kamilkarp/max2771eval/hardware/outputs/max2771eval.png

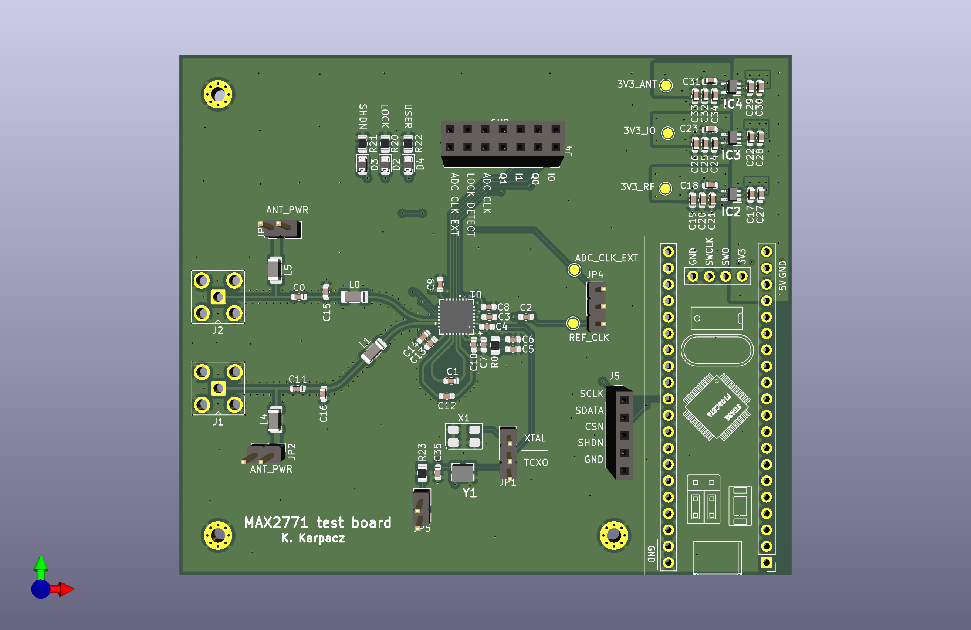
hardware/outputs/max2771eval.png
