kamilkarp/max2771eval/hardware/outputs/max2771eval.pdf

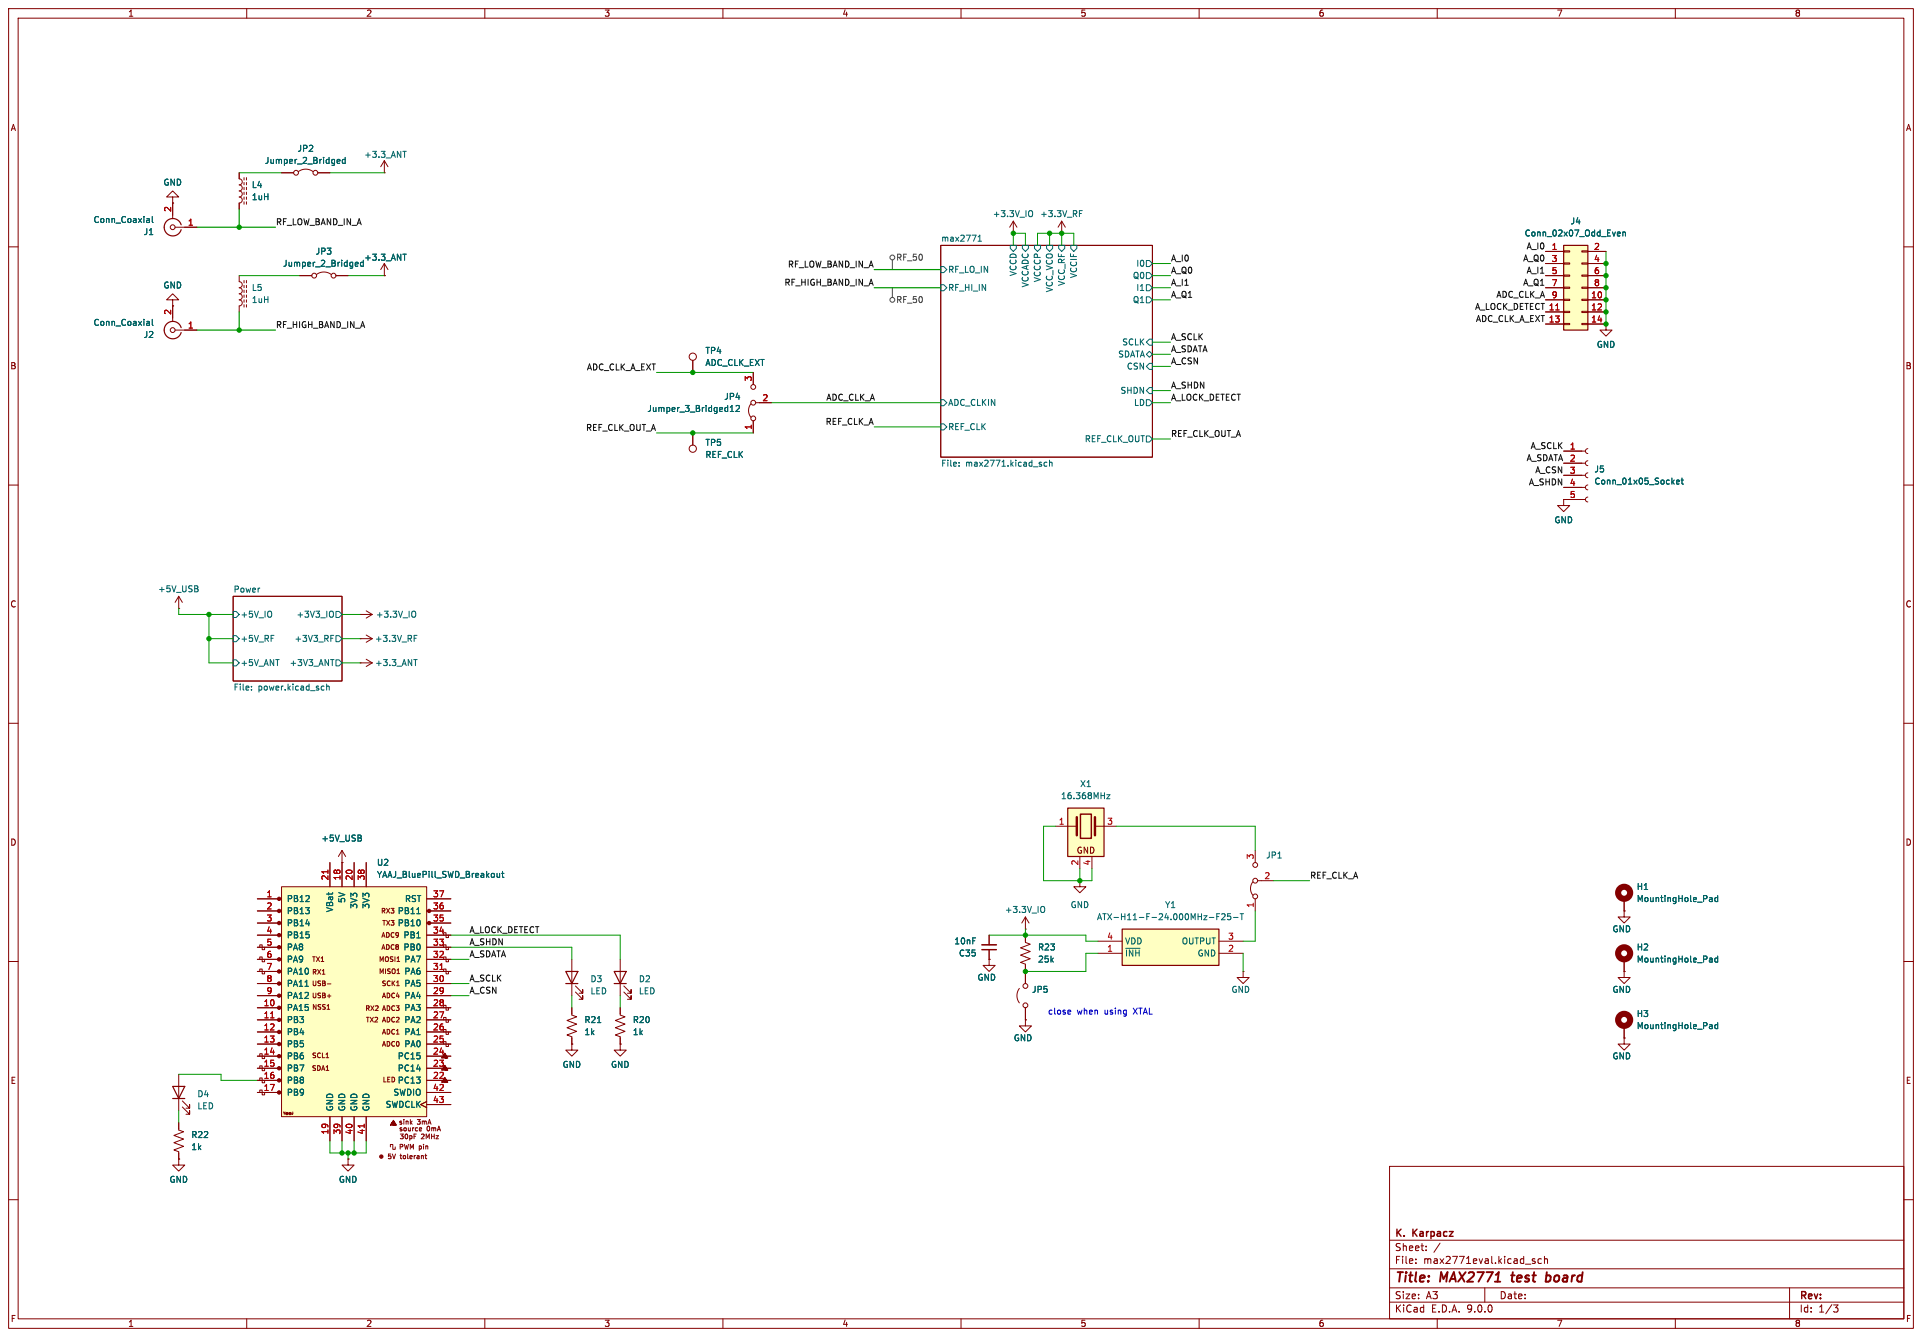
[picture p2: page 1]

close when using XTAL

Id: 1/3 Title: MAX2771 test board

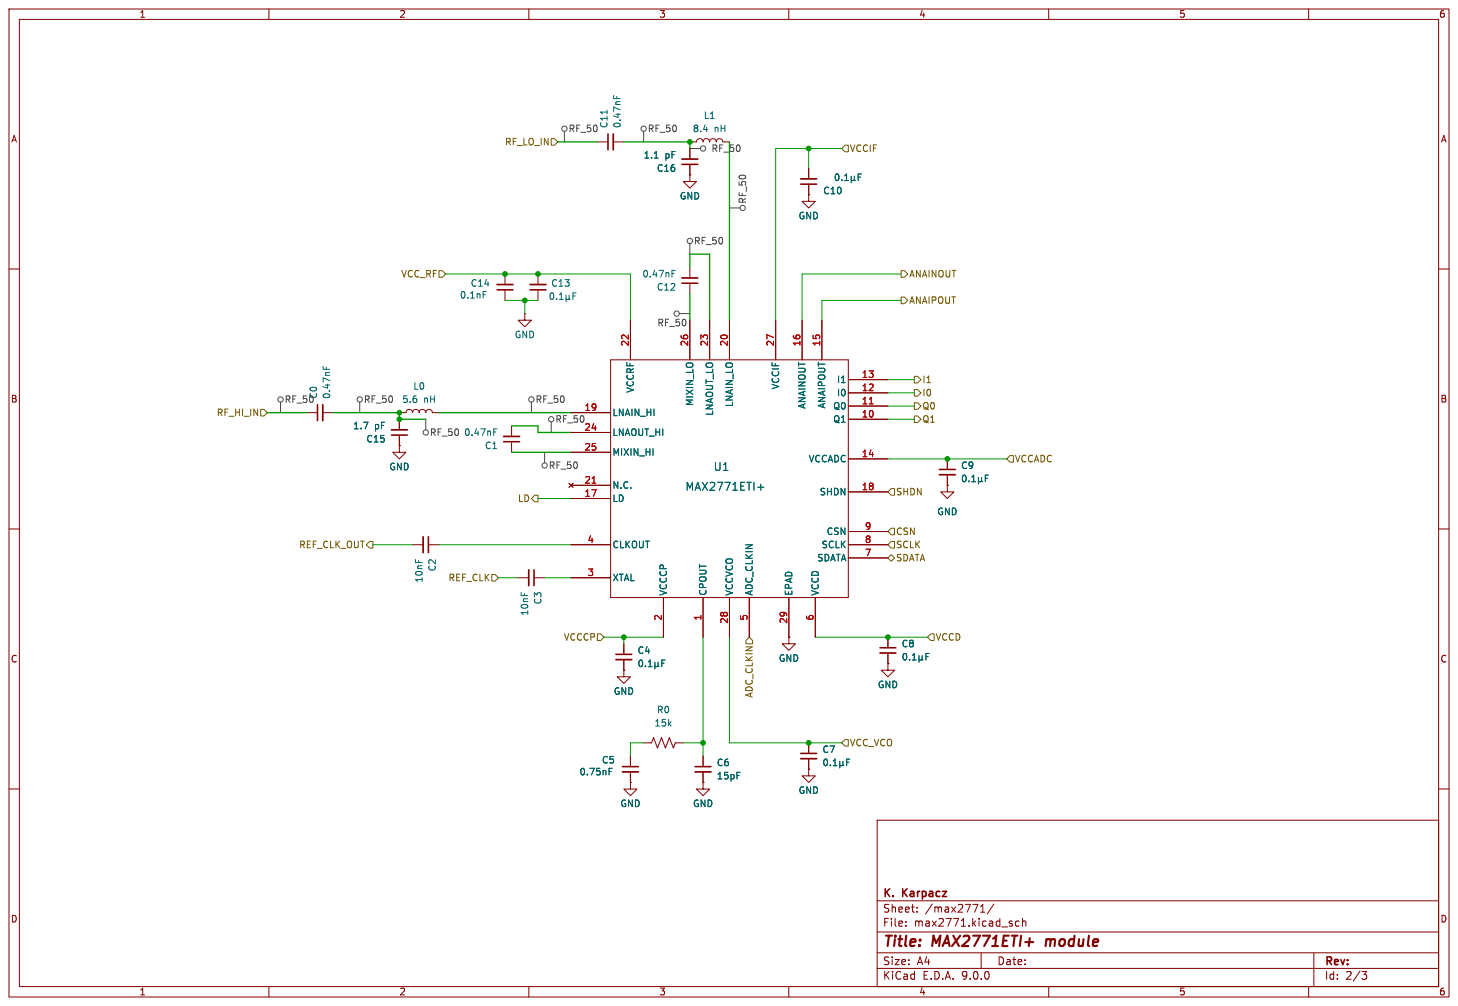
[picture p3: page 2]

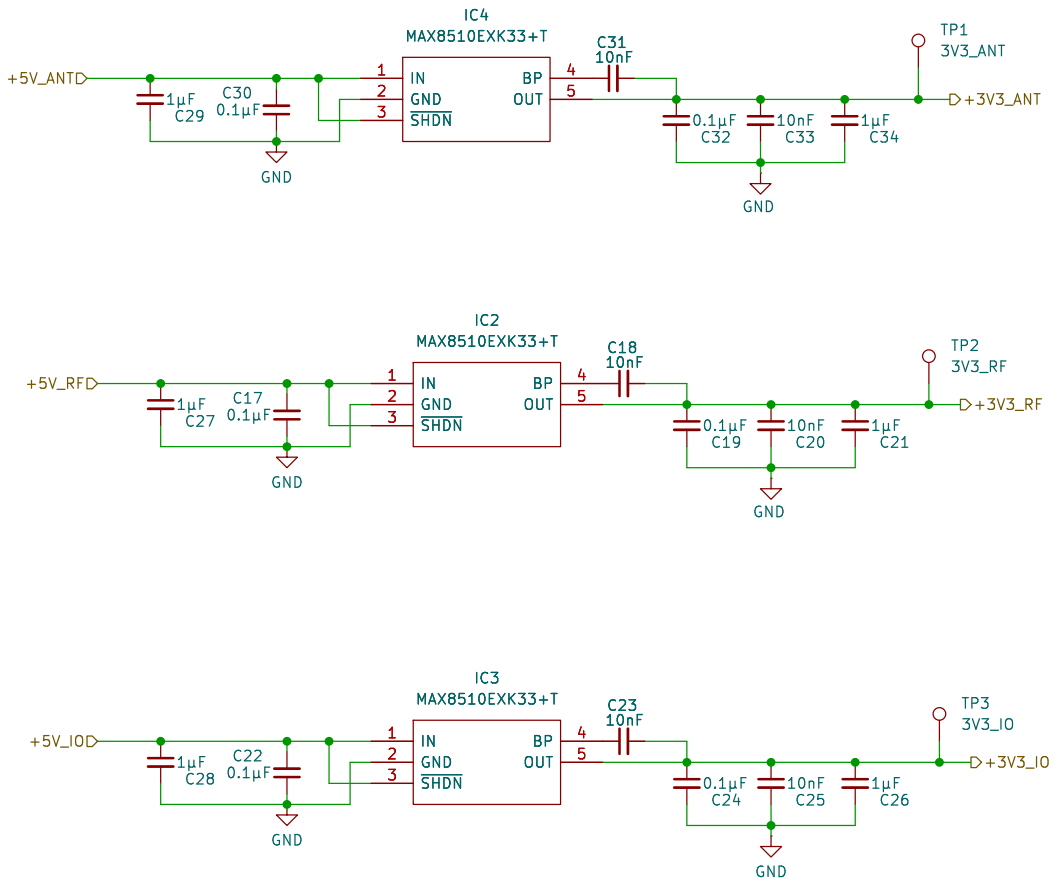
[picture p4: page 3]
