kamilkarp/max2771eval/hardware/outputs/max2771eval__Assembly.pdf

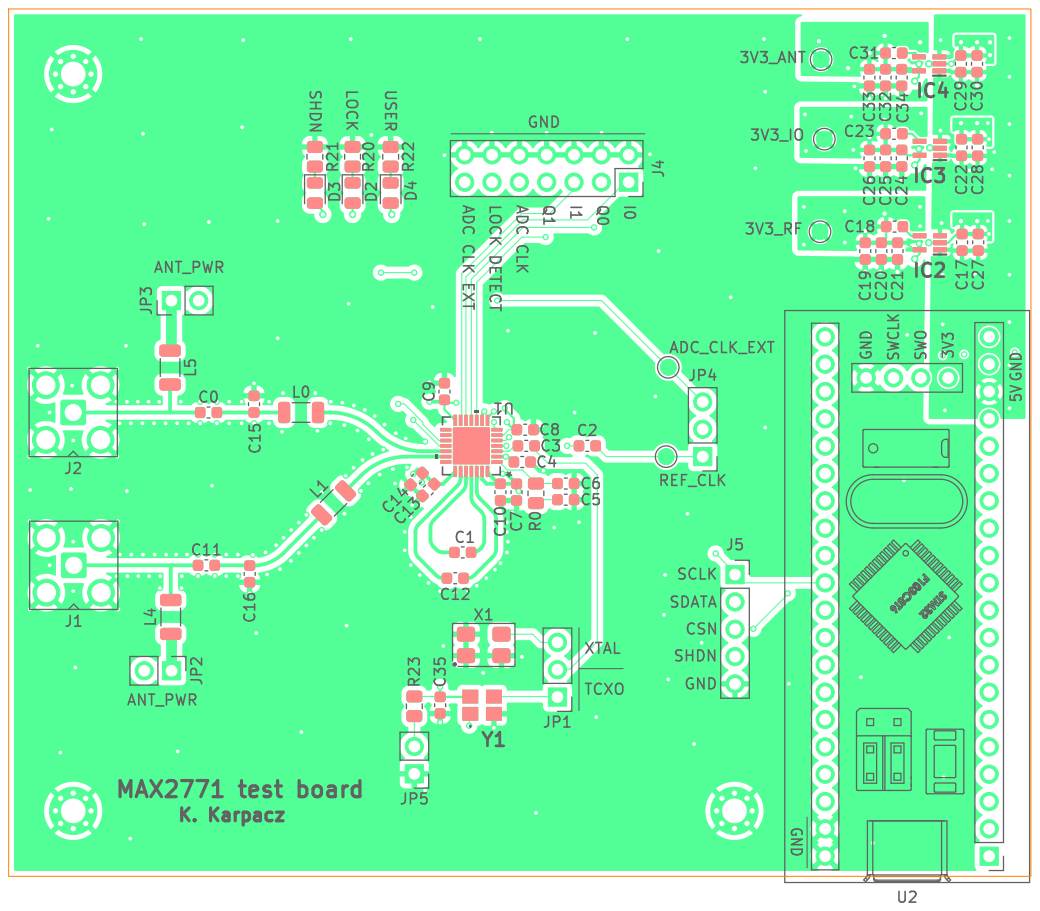
[picture p5: page 1]

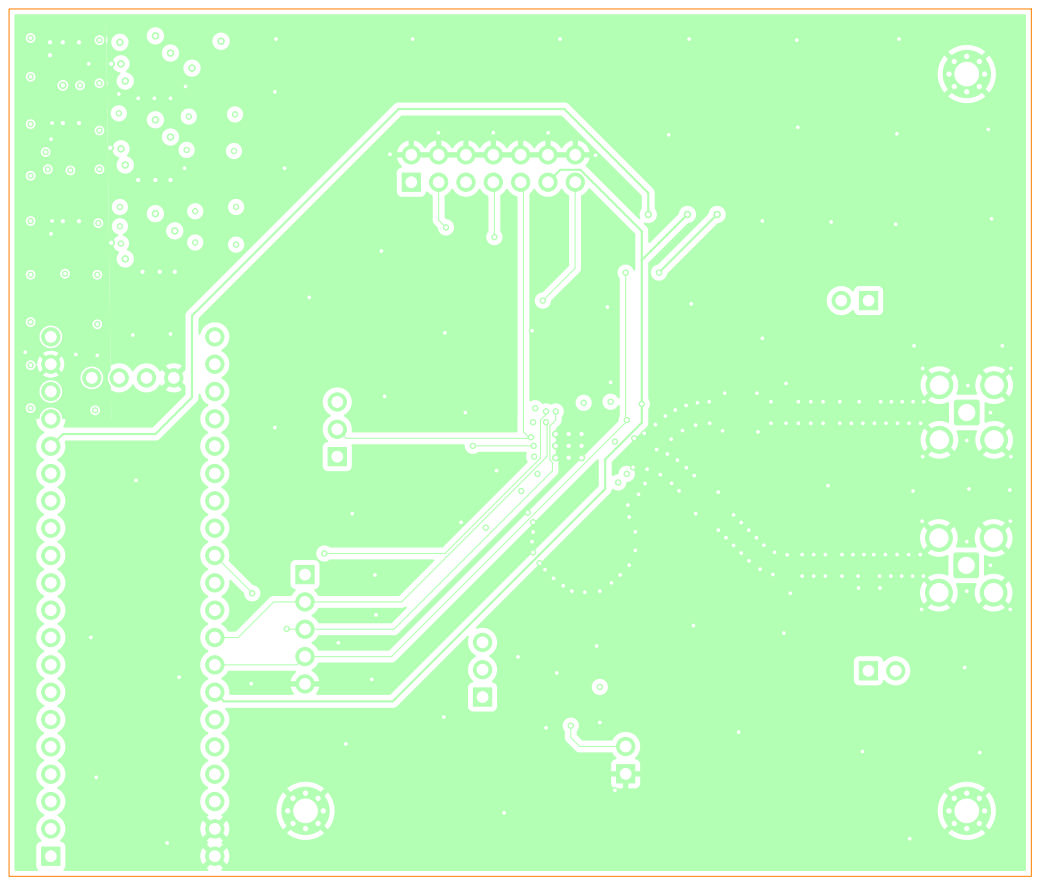
[picture p6: page 2]
D Date: KiCad; E.D.A. 9.0.0 Size: A4; Rev:; Id: /1 Title: File: max2771eval.kicad_pcb Sheet: Colored; BOT Board2Pdf:; Colored; BOT -; Page 2/2
