kamilkarp/max2771eval/hardware/max2771eval.kicad_pcb

## KiCad design hardware/max2771eval.kicad_pcb (2025-04-01)

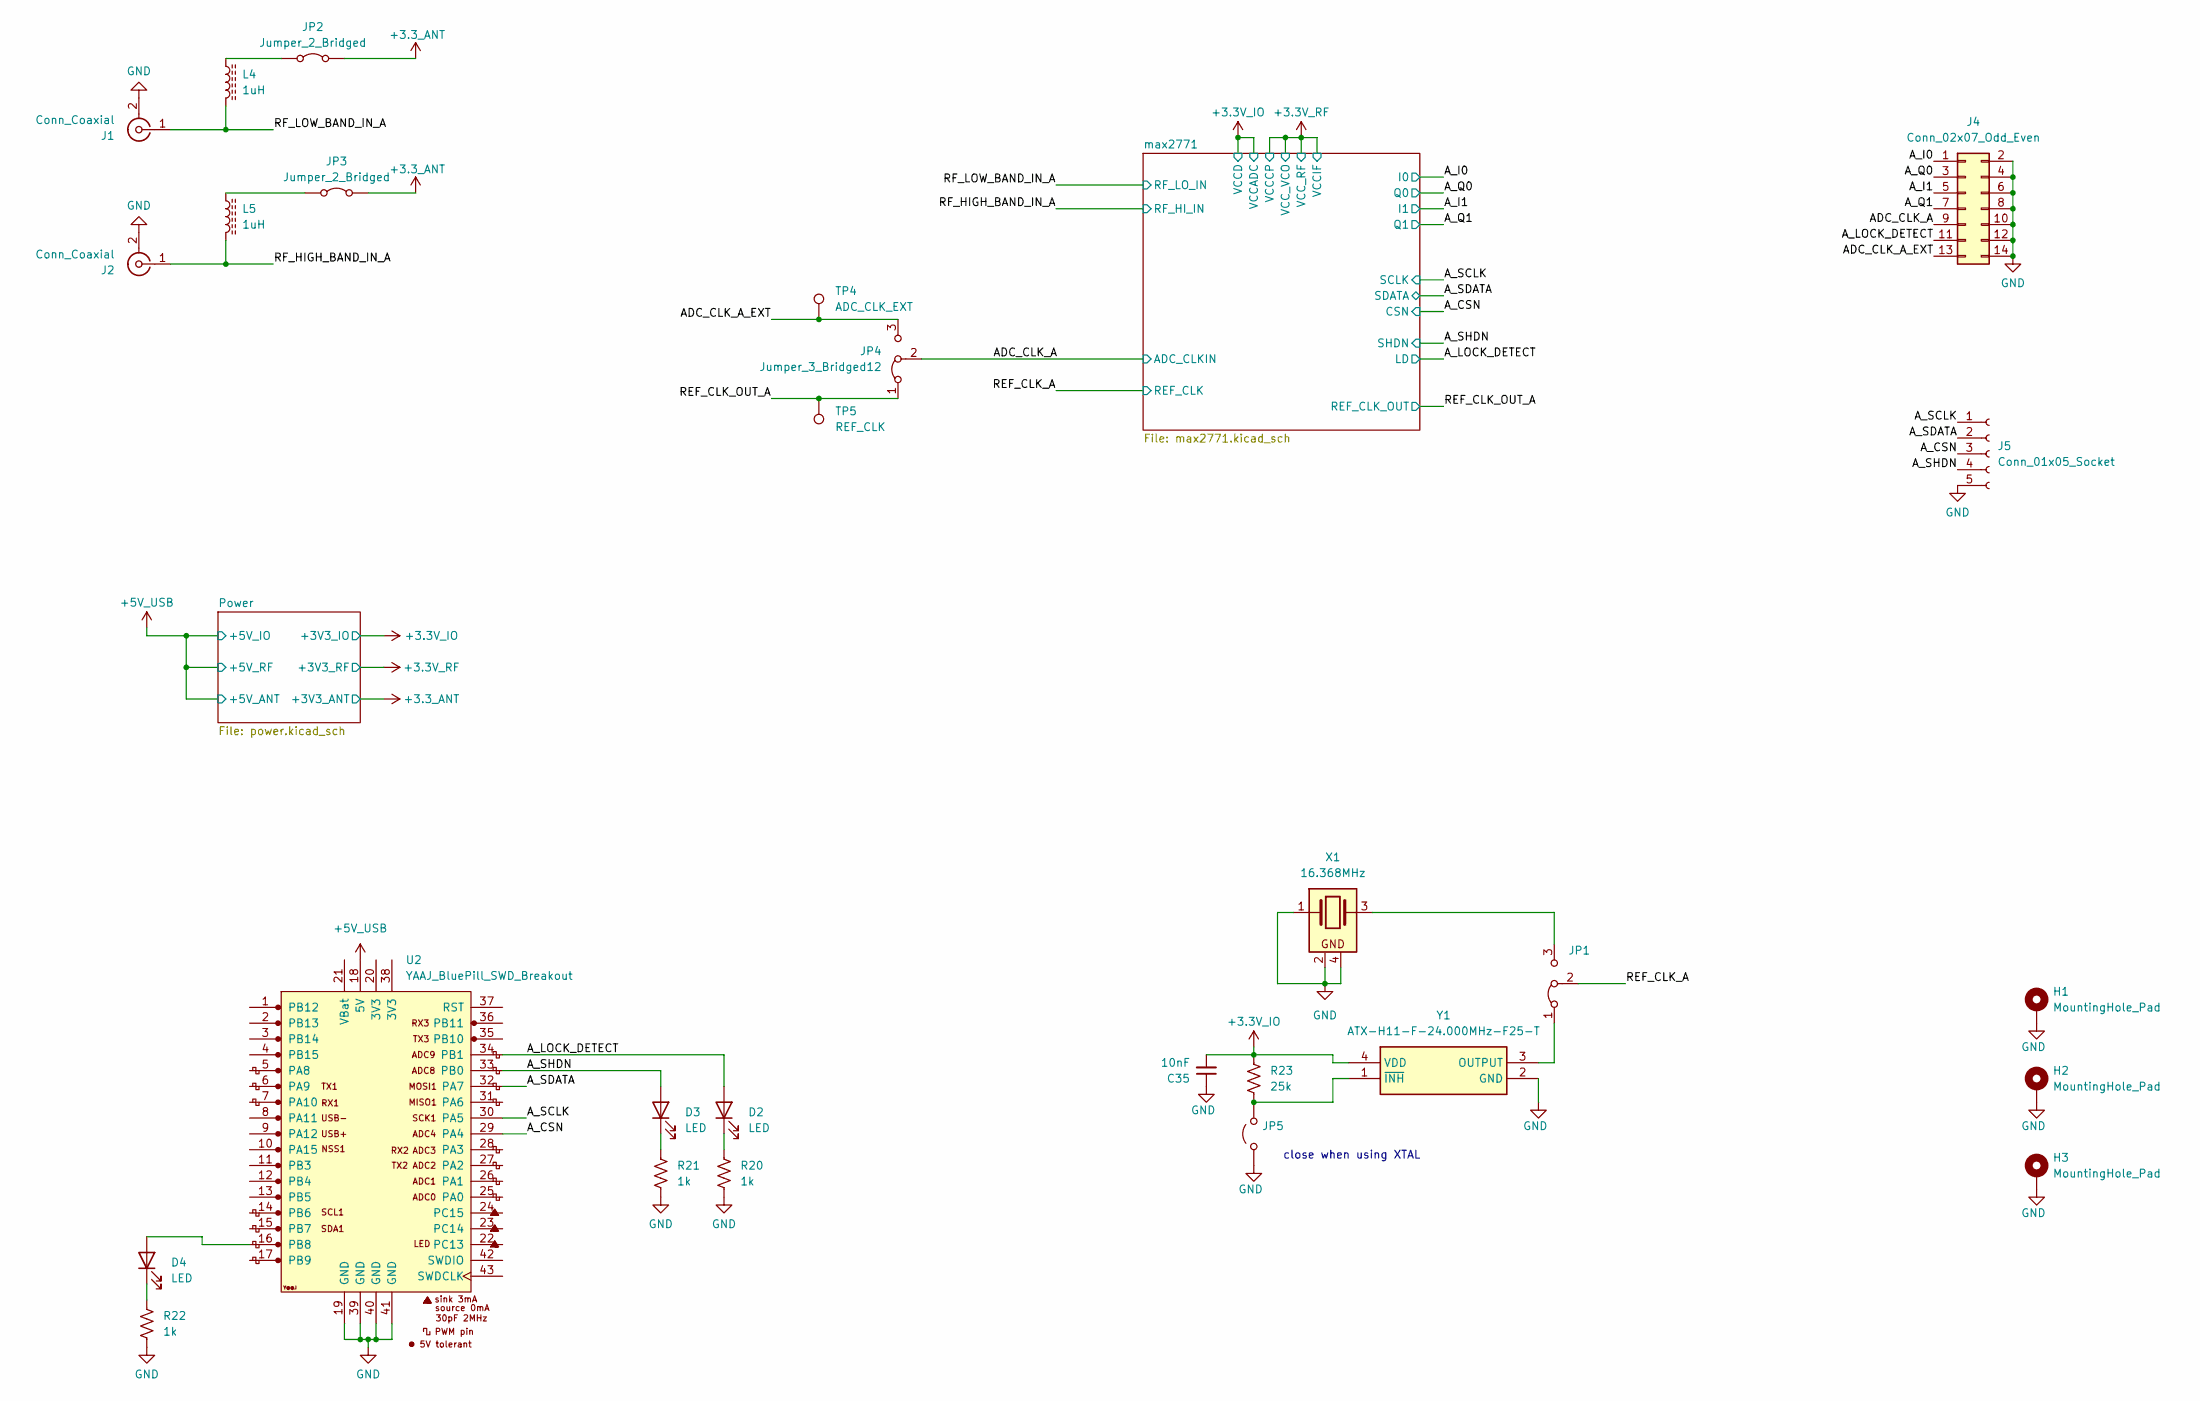
[picture p7: schematic max2771eval.kicad_sch, MAX2771 test board]

Parts:
C35: 10nF; C_0603_1608Metric
D2, D3, D4: LED; D_0805_2012Metric
H1, H2, H3: MountingHole_Pad; MountingHole_2.2mm_M2_Pad_Via
J1, J2: Conn_Coaxial; SMA_Amphenol_901-143_Horizontal
J4: Conn_02x07_Odd_Even; PinSocket_2x07_P2.54mm_Vertical
J5: Conn_01x05_Socket; PinSocket_1x05_P2.54mm_Vertical
JP1, JP4: Jumper_3_Bridged12; PinHeader_1x03_P2.54mm_Vertical
JP2, JP3: Jumper_2_Bridged; PinHeader_1x02_P2.54mm_Vertical
JP5: Jumper_2_Open; PinHeader_1x02_P2.54mm_Vertical
L4, L5: 1uH; L_1206_3216Metric
R20, R21, R22: 1k; R_0805_2012Metric
R23: 25k; R_0805_2012Metric
TP4: ADC_CLK_EXT; TestPoint_Pad_D1.5mm
TP5: REF_CLK; TestPoint_Pad_D1.5mm
U2: YAAJ_BluePill_SWD_Breakout; YAAJ_BluePill_SWD_1
X1: 16.368MHz; Crystal_SMD_5032-4Pin_5.0x3.2mm
Y1: ATX-H11-F-24.000MHz-F25-T; ATXH11F24000MHzF25T; Mouser Part Number 815-H11F24000MHZF25T

Connections:
+3.3V_IO: C35.2, R23.2, Y1.4 (VDD); also elsewhere on the board
+3.3_ANT: JP2.2 (B), JP3.2 (B); also elsewhere on the board
+5V_USB: U2.18 (5V); also elsewhere on the board
/ADC_CLK_A: J4.9, JP4.2 (C); also elsewhere on the board
/ADC_CLK_A_EXT: J4.13, JP4.3 (B), TP4.1
/A_CSN: J5.3, U2.29 (PA4); also elsewhere on the board
/A_I0: J4.1; also elsewhere on the board
/A_I1: J4.5; also elsewhere on the board
/A_LOCK_DETECT: D2.2 (A), J4.11, U2.34 (PB1); also elsewhere on the board
/A_Q0: J4.3; also elsewhere on the board
/A_Q1: J4.7; also elsewhere on the board
/A_SCLK: J5.1, U2.30 (PA5); also elsewhere on the board
/A_SDATA: J5.2, U2.32 (PA7); also elsewhere on the board
/A_SHDN: D3.2 (A), J5.4, U2.33 (PB0); also elsewhere on the board
/REF_CLK_A: JP1.2 (C); also elsewhere on the board
/REF_CLK_OUT_A: JP4.1 (A), TP5.1; also elsewhere on the board
/RF_HIGH_BAND_IN_A: J2.1 (In), L5.2; also elsewhere on the board
/RF_LOW_BAND_IN_A: J1.1 (In), L4.2; also elsewhere on the board
GND: C35.1, H1.1, H2.1, H3.1, J1.2 (Ext), J2.2 (Ext), J4.2, J4.4, J4.6, J4.8, J4.10, J4.12, J4.14, J5.5, JP5.1 (A), R20.1, R21.1, R22.1, U2.19 (GND), U2.39 (GND), U2.40 (GND), U2.41 (GND), X1.1, X1.2, X1.4, Y1.2 (GND); also elsewhere on the board
unnamed: D2.1 (K), R20.2
unnamed: D3.1 (K), R21.2
unnamed: D4.2 (A), U2.16 (PB8)
unnamed: D4.1 (K), R22.2
unnamed: JP1.1 (A), Y1.3 (OUTPUT)
unnamed: JP1.3 (B), X1.3
unnamed: JP2.1 (A), L4.1
unnamed: JP3.1 (A), L5.1
unnamed: JP5.2 (B), R23.1, Y1.1 (~INH)

Notes on the sheet:
close when using XTAL

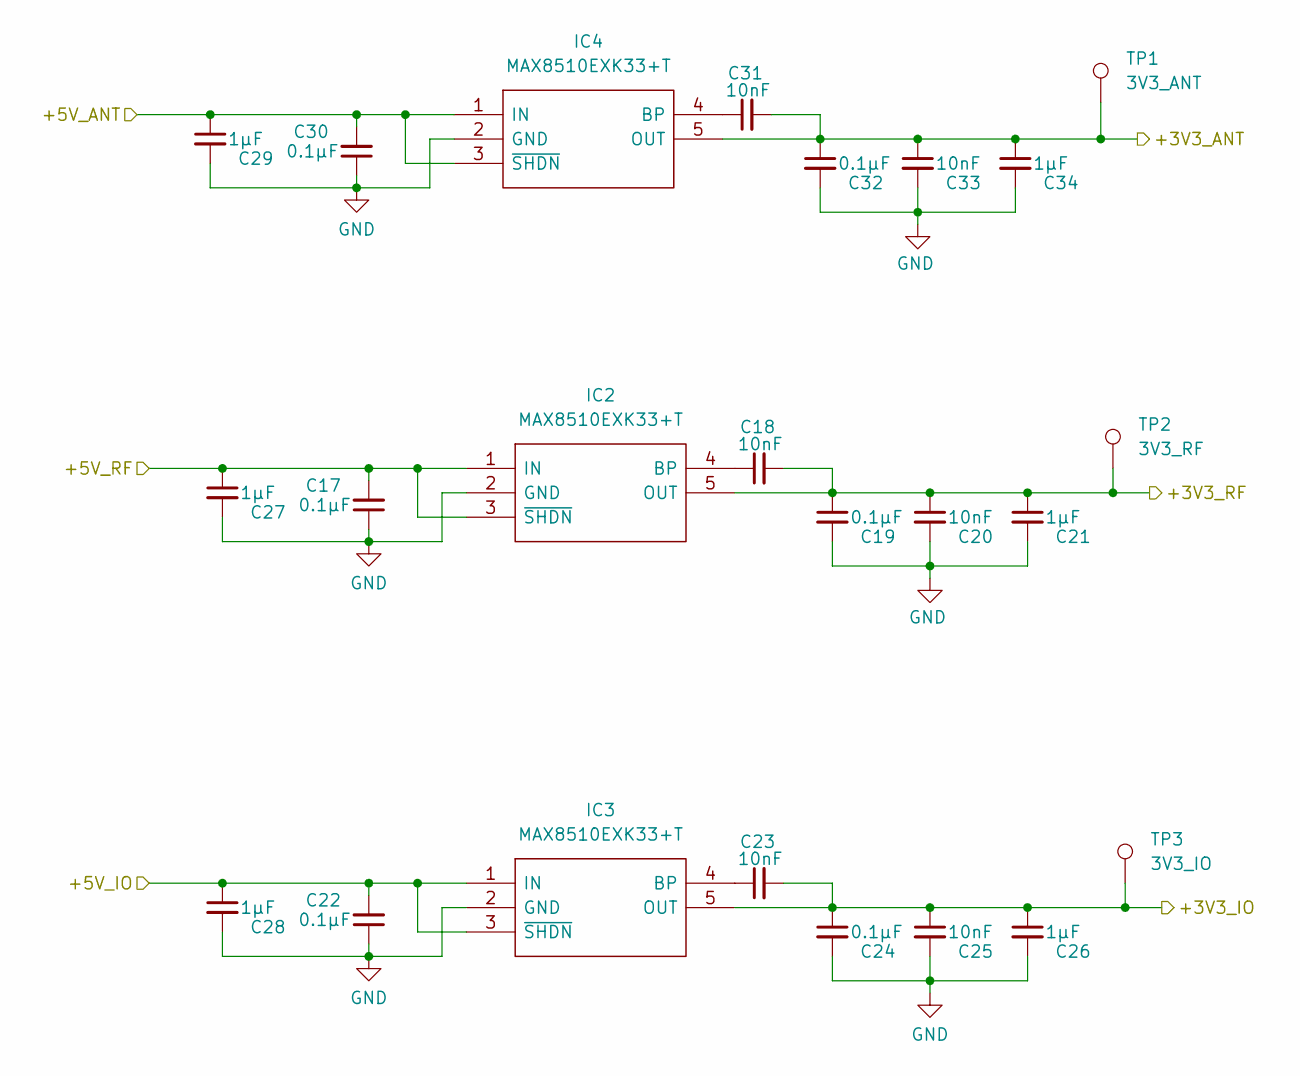
[picture p8: schematic power.kicad_sch]

Parts:
C17, C19, C22, C24, C30, C32: 0.1μF; C_0603_1608Metric
C18, C20, C23, C25, C31, C33: 10nF; C_0603_1608Metric
C21, C26, C27, C28, C29, C34: 1μF; C_0603_1608Metric
IC2, IC3, IC4: MAX8510EXK33+T; SOT65P210X110-5N; Mouser Part Number 700-MAX8510EXK33T
TP1: 3V3_ANT; TestPoint_Pad_D1.5mm
TP2: 3V3_RF; TestPoint_Pad_D1.5mm
TP3: 3V3_IO; TestPoint_Pad_D1.5mm

Connections:
+3.3V_IO: C23.2, C24.1, C25.1, C26.1, IC3.5 (OUT), TP3.1; also elsewhere on the board
+3.3V_RF: C18.2, C19.1, C20.1, C21.1, IC2.5 (OUT), TP2.1; also elsewhere on the board
+3.3_ANT: C31.2, C32.1, C33.1, C34.1, IC4.5 (OUT), TP1.1; also elsewhere on the board
+5V_USB: C17.2, C22.2, C27.1, C28.1, C29.1, C30.2, IC2.1 (IN), IC2.3 (~SHDN), IC3.1 (IN), IC3.3 (~SHDN), IC4.1 (IN), IC4.3 (~SHDN); also elsewhere on the board
GND: C17.1, C19.2, C20.2, C21.2, C22.1, C24.2, C25.2, C26.2, C27.2, C28.2, C29.2, C30.1, C32.2, C33.2, C34.2, IC2.2 (GND), IC3.2 (GND), IC4.2 (GND); also elsewhere on the board
unnamed: C18.1, IC2.4 (BP)
unnamed: C23.1, IC3.4 (BP)
unnamed: C31.1, IC4.4 (BP)

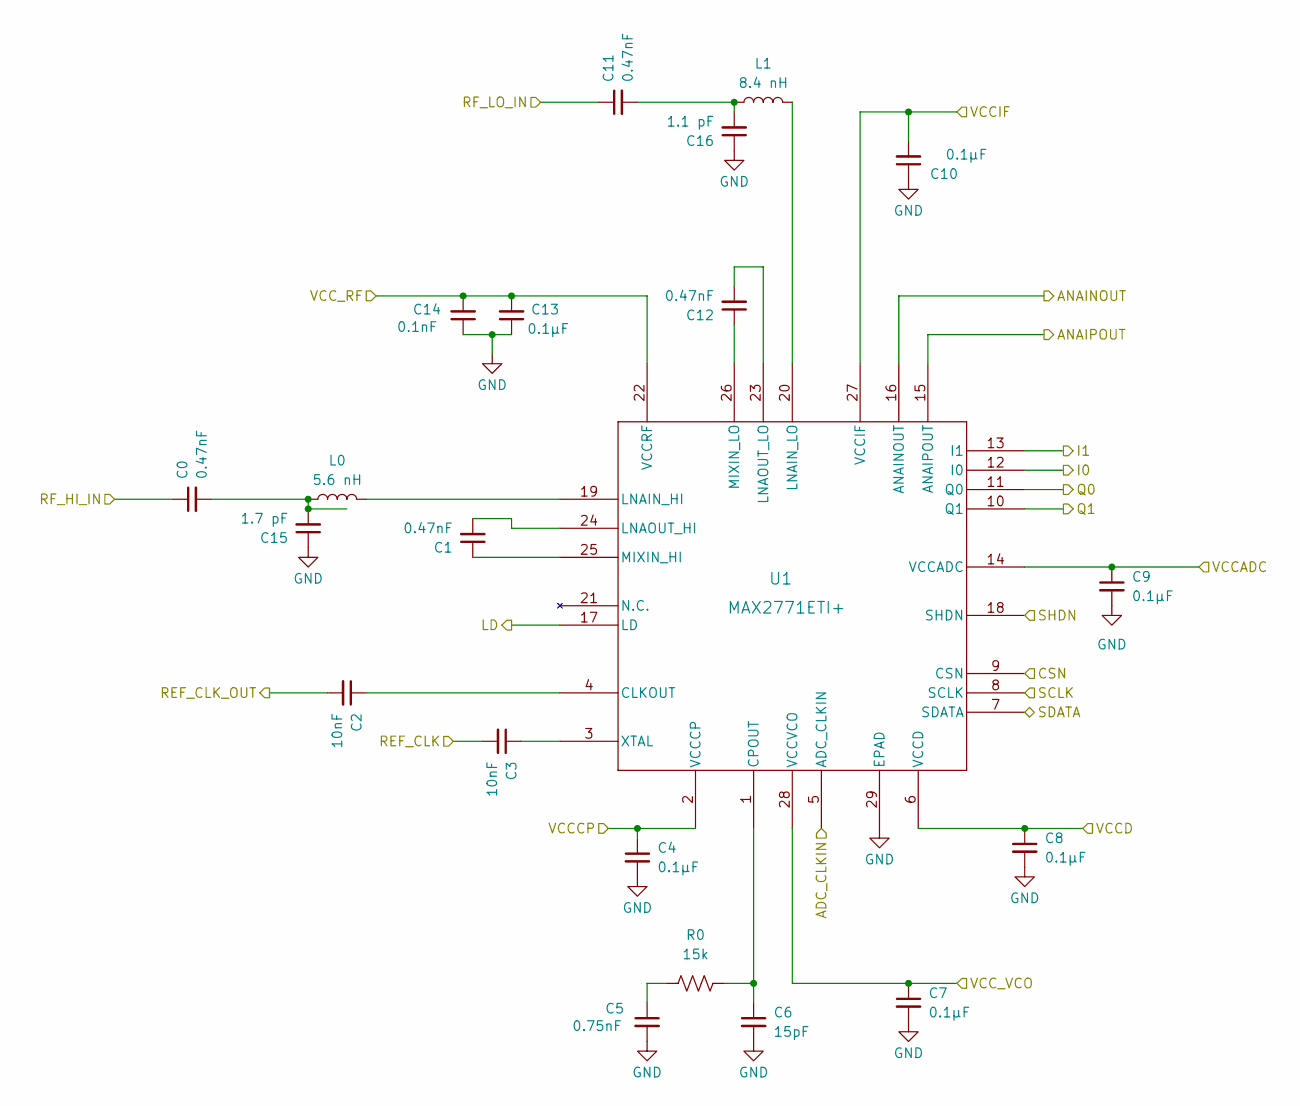
[picture p9: schematic max2771.kicad_sch, MAX2771ETI+ module]

Parts:
C0, C1, C11, C12: 0.47nF; C_0603_1608Metric
C2, C3: 10nF; C_0603_1608Metric
C4, C7, C8, C9, C10, C13: 0.1μF; C_0603_1608Metric
C5: 0.75nF; C_0603_1608Metric
C6: 15pF; C_0603_1608Metric
C14: 0.1nF; C_0603_1608Metric
C15: 1.7 pF; C_0603_1608Metric
C16: 1.1 pF; C_0603_1608Metric
L0: 5.6 nH; L_1206_3216Metric
L1: 8.4 nH; L_1206_3216Metric
R0: 15k; R_0805_2012Metric
U1: MAX2771ETI+; 21-0140L_T2855-8_MXM

Connections:
+3.3V_IO: C8.1, C9.1, U1.6 (VCCD), U1.14 (VCCADC); also elsewhere on the board
+3.3V_RF: C4.1, C7.1, C10.2, C13.2, C14.2, U1.2 (VCCCP), U1.22 (VCCRF), U1.27 (VCCIF), U1.28 (VCCVCO); also elsewhere on the board
/ADC_CLK_A: U1.5 (ADC_CLKIN); also elsewhere on the board
/A_CSN: U1.9 (CSN); also elsewhere on the board
/A_I0: U1.12 (I0); also elsewhere on the board
/A_I1: U1.13 (I1); also elsewhere on the board
/A_LOCK_DETECT: U1.17 (LD); also elsewhere on the board
/A_Q0: U1.11 (Q0); also elsewhere on the board
/A_Q1: U1.10 (Q1); also elsewhere on the board
/A_SCLK: U1.8 (SCLK); also elsewhere on the board
/A_SDATA: U1.7 (SDATA); also elsewhere on the board
/A_SHDN: U1.18 (SHDN); also elsewhere on the board
/REF_CLK_A: C3.2; also elsewhere on the board
/REF_CLK_OUT_A: C2.2; also elsewhere on the board
/RF_HIGH_BAND_IN_A: C0.1; also elsewhere on the board
/RF_LOW_BAND_IN_A: C11.1; also elsewhere on the board
/max2771/ANAINOUT: U1.16 (ANAINOUT)
/max2771/ANAIPOUT: U1.15 (ANAIPOUT)
GND: C4.2, C5.2, C6.2, C7.2, C8.2, C9.2, C10.1, C13.1, C14.1, C15.1, C16.1, U1.29 (EPAD); also elsewhere on the board
unnamed: C0.2, C15.2, L0.1
unnamed: C5.1, R0.1
unnamed: C11.2, C16.2, L1.1
unnamed: C2.1, U1.4 (CLKOUT)
unnamed: C6.1, R0.2, U1.1 (CPOUT)
unnamed: L0.2, U1.19 (LNAIN_HI)
unnamed: L1.2, U1.20 (LNAIN_LO)
unnamed: C1.2, U1.24 (LNAOUT_HI)
unnamed: C12.2, U1.23 (LNAOUT_LO)
unnamed: C1.1, U1.25 (MIXIN_HI)
unnamed: C12.1, U1.26 (MIXIN_LO)
unnamed: C3.1, U1.3 (XTAL)

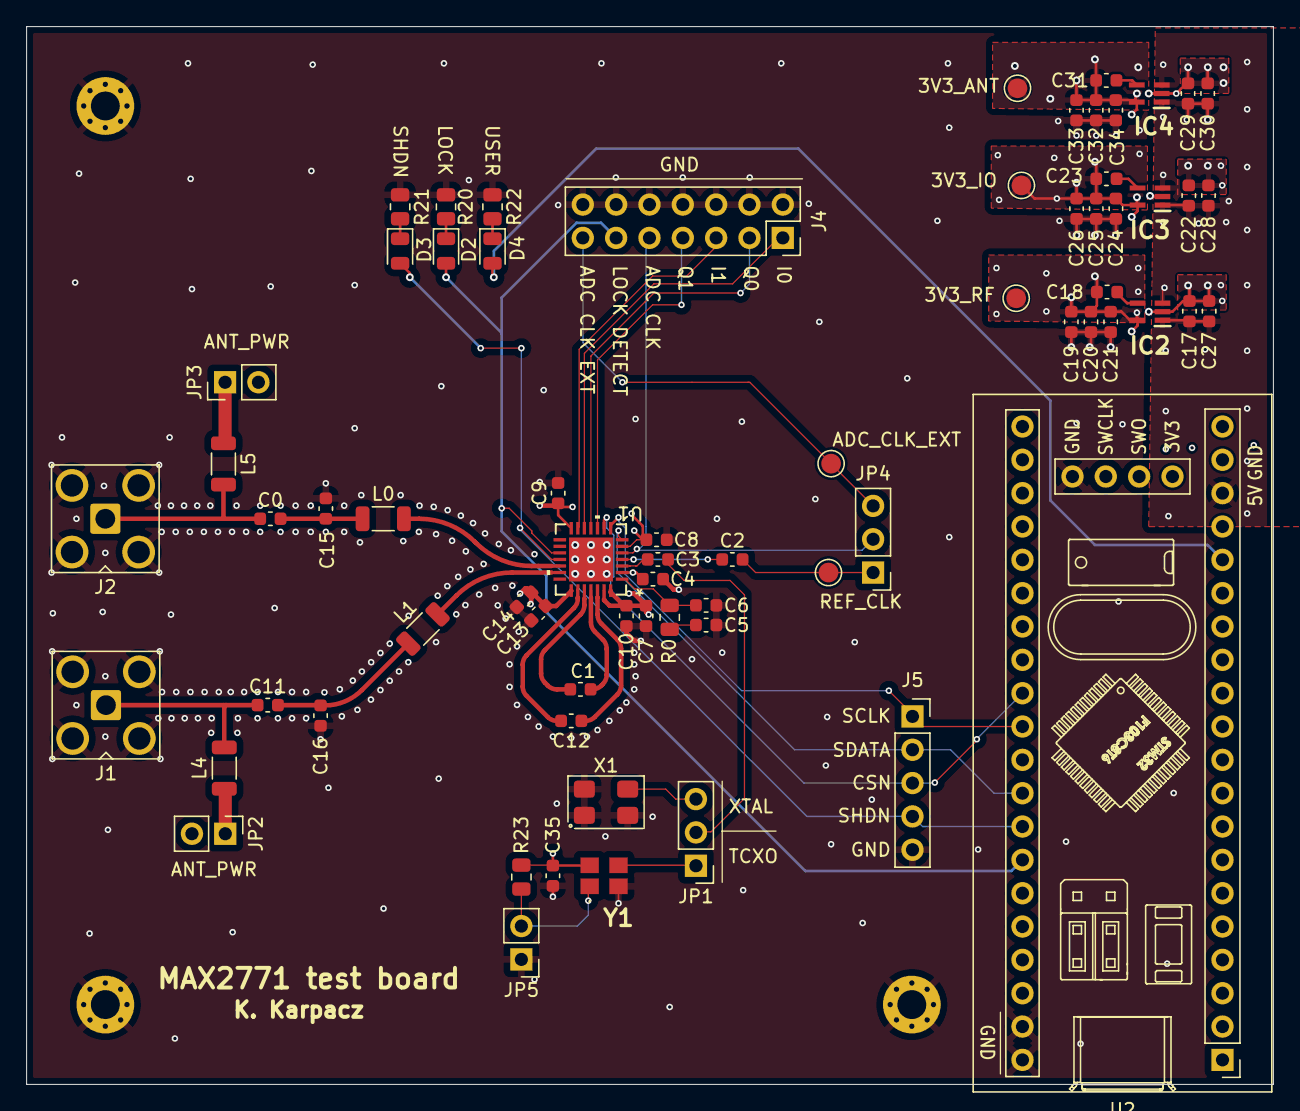
[picture p10: board max2771eval.kicad_pcb from above]

Board: 4 copper layers, 95.0 x 80.6 mm, 72 parts (0 on the bottom side), 44 nets.
