kamilkarp/max2771eval/(commit log)

2025-03-31 max2771 module
    [max2771.kicad_sch, max2771eval.kicad_sch]
2025-03-31 finished v1
    [bom.csv, designators.csv, max2771.kicad_sch, max2771eval.kicad_pcb, max2771eval.kicad_sch, positions.csv, power.kicad_sch]
2025-04-18 update bom
    [bom.csv]
2025-04-18 chore: move board to hardware folder
    [bom.csv, designators.csv, max2771.kicad_sch, max2771eval.kicad_pcb, max2771eval.kicad_sch, positions.csv, power.kicad_sch]
2025-04-18 chore: add board control app
2025-04-20 fix: configuration for board
2025-04-27 chore: l1 with IF filter preset
